will127534/CM4-Nvme-NAS/README.md

# Raspberry Pi Compute Module 4 NVMe array NAS
A simple board for Raspberry Pi Compute Module 4 plus 4x NVMe SSD using ASM1184e

Here is the main description: [https://will127534.github.io/CM4-Nvme-NAS/](https://will127534.github.io/CM4-Nvme-NAS/)

  

  

  

## Notes
* Designed with KiCad 6.0
