will127534/CM4-Nvme-NAS/RaspberryPiNVMeNAS.pdf

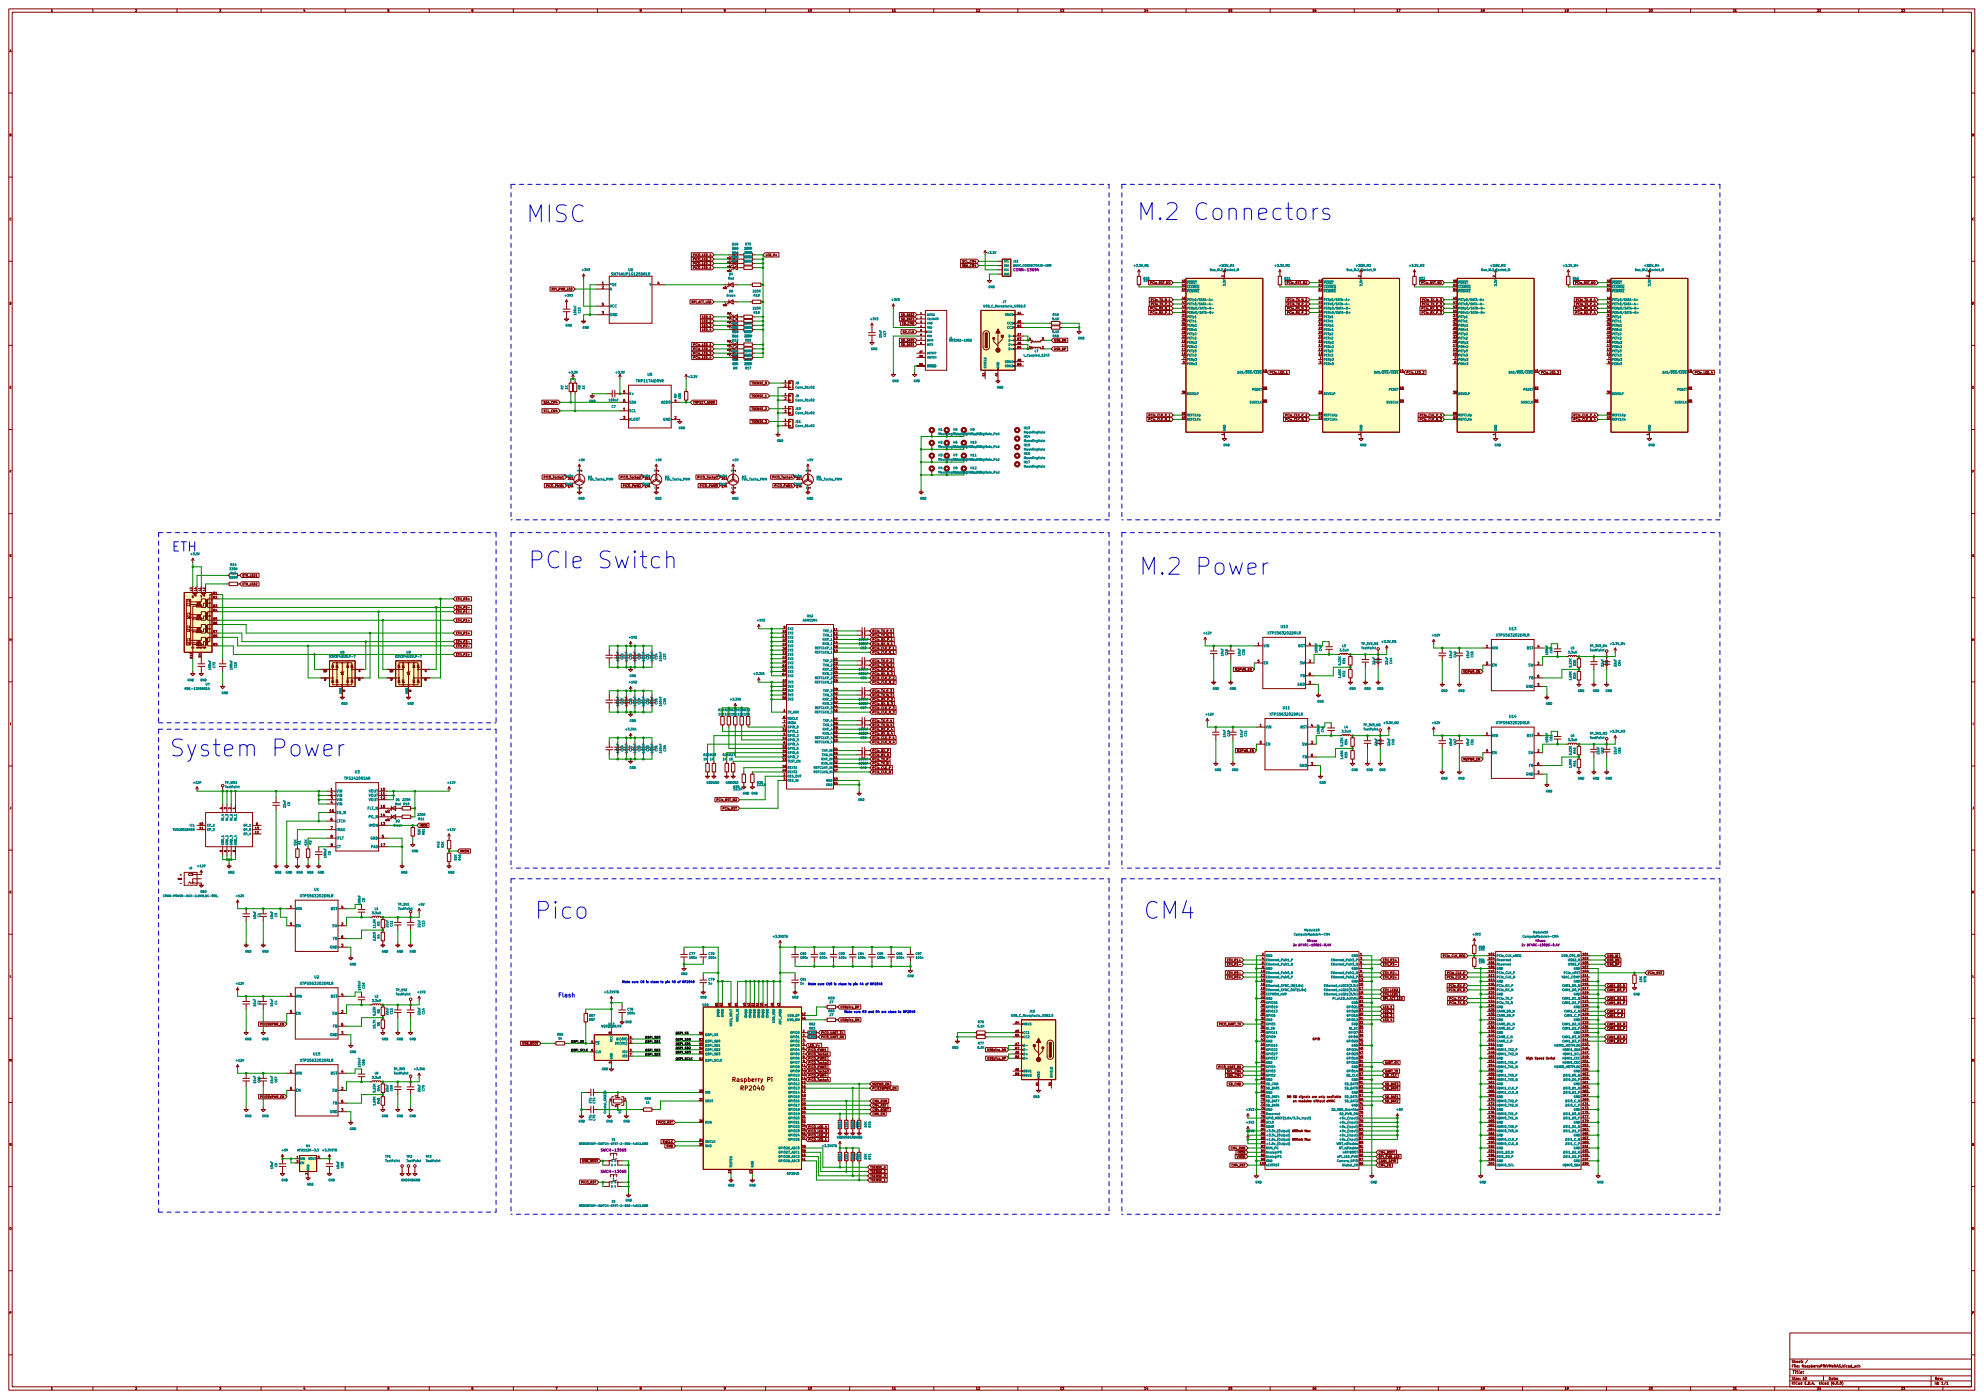
[picture p1: page 1]

H15 MountingHole H14 MountingHole H16 MountingHole H13 MountingHole H2MountingHole_Pad H4MountingHole_Pad H3MountingHole_Pad
H1MountingHole_Pad

GND GND

600mA Max 600mA Max NB SD signals are only available

4 S1 MOMENTARY-SWITCH-SPST-2-SMD-4.6X2.8MM SWCH-13065

4 S2 MOMENTARY-SWITCH-SPST-2-SMD-4.6X2.8MM SWCH-13065
