will127534/CM4-Nvme-NAS/RaspberryPiNVMeNAS.kicad_sch

## KiCad design RaspberryPiNVMeNAS.kicad_sch (2022-01-05)

Schematic: RaspberryPiNVMeNAS.kicad_sch

Parts:
C1, C2, C3, C4, C8, C17, C18, C19, C20, C21, C46, C47, C50, C51, C66, C67, C88: 10uF; C_0805_2012Metric
C5: 22uF; C_0402_1005Metric
C6, C7, C9, C10, C15, C16, C22, C23, C24, C25, C26, C27, C28, C29, C30, C31, C32, C33, C34, C35, C36, C37, C38, C39, C40, C41, C48, C49, C52, C53, C54, C55, C56, C57, C58, C59, C60, C61, C68: 100nF; C_0402_1005Metric
C11, C12, C13, C14, C42, C43, C44, C45, C62, C63, C64, C65, C69, C70: 22uF; C_0805_2012Metric
C73: 100nF; C_1206_3216Metric
C74, C75: 27p; C_0402_1005Metric
C76, C77, C78, C80, C82, C83, C84, C85, C86, C87: 100n; C_0402_1005Metric
C79, C81: 1u; C_0402_1005Metric
D1, D3, D4, D5, D7, D8, D9, D10, D11, D12, D13, D14, D15, D16: Red; LED_0603_1608Metric
D2, D6: Green; LED_0603_1608Metric
H1, H2, H3, H4, H5, H6, H7, H8, H9, H10, H11, H12: MountingHole_Pad; MountingHole_2.7mm_M2.5_Pad_TopOnly
H13, H14, H15, H16, H17: MountingHole; MountingHole_2.7mm_M2.5
IC1: TVS1801DRBR; TPS73601DRBR; Mouser Part Number 595-TVS1801DRBR
J1: 503182-1852; MOLEX_503182-1852
J2, J3, J4, J5: Bus_M.2_Socket_M; 1-2199230-6
J6: CONN-POWER-JACK-2.1MM_DC-005_; DCJ3P-11.6X9.6X7.0MM; MPN DC-005
J7, J15: USB_C_Receptacle_USB2.0; USB_C_Receptacle_XKB_U262-16XN-4BVC11
J8, J9, J10, J11: Conn_01x02; PinHeader_1x02_P2.00mm_Vertical
J12: QWIIC_CONNECTORJS-1MM; 1X04_1MM_RA
L1, L2, L3, L4, L5, L6, L8: 3.3uH; L_Vishay_IHLP-1212
L7: L_Coupled_1243; L_CommonModeChoke_Coilcraft_0805USB
M1, M2, M3, M4: Fan_Tacho_PWM; FanPinHeader_1x04_P2.54mm_Vertical
Module1: ComputeModule4-CM4; Raspberry-Pi-4-Compute-Module
R1, R2, R43, R46, R61: 52K; R_0402_1005Metric
R3: 11.5K; R_0402_1005Metric
R4: 2.21K; R_0402_1005Metric
R5, R31, R34, R38, R40, R44: 5.23K; R_0402_1005Metric
R6: 10.7K; R_0402_1005Metric
R7, R8, R22, R23, R25, R27: 1K; R_0402_1005Metric
R9, R20, R21, R24, R26, R28, R29, R33, R37, R42, R50, R51, R64, R65, R66, R67, R68, R69, R70, R71, R78: 10K; R_0402_1005Metric
R10, R11, R12, R13, R16, R17, R18, R19, R52, R53, R54, R55, R62, R63, R72, R73, R74, R75: 220R; R_0402_1005Metric
R14, R15: 330R; R_0402_1005Metric
R30, R36: 12.1K; R_0402_1005Metric
R32, R35, R39, R41, R45: 1.69K; R_0402_1005Metric
R48, R49, R76, R77: 5.1K; R_0402_1005Metric
R56, R58: 1k; C_0402_1005Metric
R57: DNF; C_0402_1005Metric
R59, R60: 27; C_0402_1005Metric
S1, S2: MOMENTARY-SWITCH-SPST-2-SMD-4.6X2.8MM; TACTILE_SWITCH_SMD_4.6X2.8MM
TP1, TP2, TP3: TestPoint; TestPoint_Pad_D1.0mm
TP_1V2, TP_3V3, TP_3V3_M1, TP_3V3_M2, TP_3V3_M3, TP_3V3_M4, TP_5V1: TestPoint; TestPoint_Pad_D1.0mm
TP_VIN1: TestPoint; TestPoint_Pad_D1.0mm
U1, U2, U10, U11, U13, U14, U15: XTPS563202DRLR
U3: TPS2420RSAR
U4: AP2112K-3.3; SOT-23-5
U5: TMP117AIDRVR
U6: SN74AUP1G125DRLR
U7: RB1-125B8G1A; RJ45_UDE_RB1-125B8G1A
U8, U9: D3V3F4U10LP-7; Diodes_UDFN-10_1.0x2.5mm_P0.5mm
U12: ASM1184; QFN-64-1EP_9x9mm_P0.5mm_EP5.2x5.2mm
U17: W25Q128JVS; DFN-8-1EP_3x2mm_P0.5mm_EP1.36x1.46mm
U18: RP2040; RP2040-QFN-56
Y1: Crystal_GND24; Crystal_SMD_3225-4Pin_3.2x2.5mm

Connections:
+1V2: C12.1, C14.1, C22.1, C23.1, C25.1, C26.1, C28.1, C29.1, C31.1, C32.1, C34.1, C35.1, C37.1, C38.1, L2.2, R5.1, TP_1V2.1, U12.9 (1V2), U12.15 (1V2), U12.17 (1V2), U12.20 (1V2), U12.26 (1V2), U12.29 (1V2), U12.37 (1V2), U12.43 (1V2), U12.48 (1V2), U12.50 (1V2), U12.61 (1V2), U12.64 (1V2)
+1V8: Module1.88 (+1.8v_(Output)), Module1.90 (+1.8v_(Output))
+3.3V: C7.1, J12.2 (VCC), R7.2, R8.2, R9.2, U5.5 (V+), U7.L1, U7.L3
+3.3VA: C24.1, C27.1, C30.1, C33.1, C36.1, C39.1, C69.1, C70.1, L8.2, R24.1, R26.1, R28.1, R29.1, R33.1, R44.1, TP_3V3.1, U12.1 (3V_AUX), U12.10 (3V3), U12.21 (3V3), U12.32 (3V3), U12.38 (3V3), U12.56 (3V3)
+3.3VSTB: C76.1, C80.1, C81.1, C82.1, C83.1, C84.1, C85.1, C86.1, C87.1, C88.1, R57.1, R65.1, R67.1, R69.1, R71.1, U4.5 (VOUT), U17.8 (VCC), U18.1 (IOVDD), U18.10 (IOVDD), U18.22 (IOVDD), U18.33 (IOVDD), U18.42 (IOVDD), U18.43 (ADC_AVDD), U18.44 (VREG_IN), U18.48 (USB_VDD), U18.49 (IOVDD)
+3.3V_M1: C42.1, C44.1, J2.2 (3.3V), J2.4 (3.3V), J2.12 (3.3V), J2.14 (3.3V), J2.16 (3.3V), J2.18 (3.3V), J2.70 (3.3V), J2.72 (3.3V), J2.74 (3.3V), L3.2, R20.1, R31.1, TP_3V3_M1.1
+3.3V_M2: C43.1, C45.1, J3.2 (3.3V), J3.4 (3.3V), J3.12 (3.3V), J3.14 (3.3V), J3.16 (3.3V), J3.18 (3.3V), J3.70 (3.3V), J3.72 (3.3V), J3.74 (3.3V), L4.2, R21.1, R34.1, TP_3V3_M2.1
+3.3V_M3: C63.1, C65.1, J4.2 (3.3V), J4.4 (3.3V), J4.12 (3.3V), J4.14 (3.3V), J4.16 (3.3V), J4.18 (3.3V), J4.70 (3.3V), J4.72 (3.3V), J4.74 (3.3V), L6.2, R37.1, R40.1, TP_3V3_M3.1
+3.3V_M4: C62.1, C64.1, J5.2 (3.3V), J5.4 (3.3V), J5.12 (3.3V), J5.14 (3.3V), J5.16 (3.3V), J5.18 (3.3V), J5.70 (3.3V), J5.72 (3.3V), J5.74 (3.3V), L5.2, R38.1, R42.1, TP_3V3_M4.1
+3V3: C15.1, C17.1, J1.4 (VDD), Module1.78 (GPIO_VREF(1.8v/3.3v_Input)), Module1.84 (+3.3v_(Output)), Module1.86 (+3.3v_(Output)), R50.1, U6.5 (VCC)
+5V: C8.1, C11.1, C13.1, L1.2, M1.2 (+), M2.2 (+), M3.2 (+), M4.2 (+), Module1.77 (+5v_(Input)), Module1.79 (+5v_(Input)), Module1.81 (+5v_(Input)), Module1.83 (+5v_(Input)), Module1.85 (+5v_(Input)), Module1.87 (+5v_(Input)), R3.1, TP_5V1.1, U4.1 (VIN), U4.3 (EN)
+12P: C5.1, IC1.1 (IN_1), IC1.2 (IN_2), IC1.3 (IN_3), IC1.4 (IN_4), J6.1 (+), TP_VIN1.1, U3.1 (VIN), U3.2 (VIN), U3.3 (VIN), U3.4 (VIN)
+12V: C1.1, C2.1, C3.1, C4.1, C18.1, C19.1, C20.1, C21.1, C46.1, C47.1, C50.1, C51.1, C66.1, C67.1, R10.1, R11.1, R43.2, U1.1 (VIN), U1.5 (EN), U2.1 (VIN), U3.10 (VOUT), U3.11 (VOUT), U3.12 (VOUT), U10.1 (VIN), U11.1 (VIN), U13.1 (VIN), U14.1 (VIN), U15.1 (VIN)
CAM1_C_N: Module1.127 (CAM1_C_N)
CAM1_C_P: Module1.129 (CAM1_C_P)
CAM1_D0_N: Module1.115 (CAM1_D0_N)
CAM1_D0_P: Module1.117 (CAM1_D0_P)
CAM1_D1_N: Module1.121 (CAM1_D1_N)
CAM1_D1_P: Module1.123 (CAM1_D1_P)
CAM1_D2_N: Module1.133 (CAM1_D2_N)
CAM1_D2_P: Module1.135 (CAM1_D2_P)
CAM1_D3_N: Module1.139 (CAM1_D3_N)
CAM1_D3_P: Module1.141 (CAM1_D3_P)
CAM1_GPIO: Module1.97 (Camera_GPIO)
CM4_BOOT: Module1.93 (nRPIBOOT), U18.29 (GPIO18)
CM4_EN: Module1.99 (Global_EN), R64.1, U18.30 (GPIO19)
CM4_RST: Module1.100 (nEXTRST), U18.28 (GPIO17)
CM4_RUN: Module1.92 (RUN_PG), R66.1, U18.27 (GPIO16)
ETH_LED1: Module1.19 (Ethernet_nLED1(3.3v)), R14.2
ETH_LED2: Module1.17 (Ethernet_nLED2(3.3v)), R15.2
ETH_P0+: Module1.12 (Ethernet_Pair0_P), U7.R2 (TD1+), U9.5, U9.6 (NC)
ETH_P0-: Module1.10 (Ethernet_Pair0_N), U7.R3 (TD1-), U9.4, U9.7 (NC)
ETH_P1+: Module1.4 (Ethernet_Pair1_P), U7.R5 (TD2-), U9.1, U9.10 (NC)
ETH_P1-: Module1.6 (Ethernet_Pair1_N), U7.R4 (TD2+), U9.2, U9.9 (NC)
ETH_P2+: Module1.11 (Ethernet_Pair2_P), U7.R9 (TD4-), U8.1, U8.10 (NC)
ETH_P2-: Module1.9 (Ethernet_Pair2_N), U7.R8 (TD4+), U8.2, U8.9 (NC)
ETH_P3+: Module1.3 (Ethernet_Pair3_P), U7.R6 (TD3+), U8.5, U8.6 (NC)
ETH_P3-: Module1.5 (Ethernet_Pair3_N), U7.R7 (TD3-), U8.4, U8.7 (NC)
GND: C1.2, C2.2, C3.2, C4.2, C5.2, C6.2, C7.2, C8.2, C11.2, C12.2, C13.2, C14.2, C15.2, C16.2, C17.2, C18.2, C19.2, C20.2, C21.2, C22.2, C23.2, C24.2, C25.2, C26.2, C27.2, C28.2, C29.2, C30.2, C31.2, C32.2, C33.2, C34.2, C35.2, C36.2, C37.2, C38.2, C39.2, C42.2, C43.2, C44.2, C45.2, C46.2, C47.2, C50.2, C51.2, C62.2, C63.2, C64.2, C65.2, C66.2, C67.2, C69.2, C70.2, C73.2, C74.2, C75.2, C76.2, C77.2, C78.2, C79.2, C80.2, C81.2, C82.2, C83.2, C84.2, C85.2, C86.2, C87.2, C88.2, H1.1, H2.1, H3.1, H4.1, H5.1, H6.1, H7.1, H8.1, H9.1, H10.1, H11.1, H12.1, IC1.5 (GND_1), IC1.6 (GND_2), IC1.7 (GND_3), IC1.8 (GND_4), J1.6 (VSS), J1.P1 (SHIELD), J1.P2 (SHIELD), J1.P3 (SHIELD), J1.P4 (SHIELD), J1.P5 (SHIELD), J2.1 (GND), J2.3 (GND), J2.9 (GND), J2.15 (GND), J2.21 (GND), J2.27 (GND), J2.33 (GND), J2.39 (GND), J2.45 (GND), J2.51 (GND), J2.57 (GND), J2.71 (GND), J2.73 (GND), J2.75 (GND), J3.1 (GND), J3.3 (GND), J3.9 (GND), J3.15 (GND), J3.21 (GND), J3.27 (GND), J3.33 (GND), J3.39 (GND), J3.45 (GND), J3.51 (GND), J3.57 (GND), J3.71 (GND), J3.73 (GND), J3.75 (GND), J4.1 (GND), J4.3 (GND), J4.9 (GND), J4.15 (GND), J4.21 (GND), J4.27 (GND), J4.33 (GND), J4.39 (GND), J4.45 (GND), J4.51 (GND), J4.57 (GND), J4.71 (GND), J4.73 (GND), J4.75 (GND), J5.1 (GND), J5.3 (GND), J5.9 (GND), J5.15 (GND), J5.21 (GND), J5.27 (GND), J5.33 (GND), J5.39 (GND), J5.45 (GND), J5.51 (GND), J5.57 (GND), J5.71 (GND), J5.73 (GND), J5.75 (GND), J6.2 (-), J7.A1 (GND), J7.A12 (GND), J7.B1 (GND), J7.B12 (GND), J8.2, J9.2, J10.2, J11.2, J12.1 (GND), J15.A1 (GND), J15.A12 (GND), J15.B1 (GND), J15.B12 (GND), M1.1 (-), M2.1 (-), M3.1 (-), M4.1 (-), Module1.1 (GND), Module1.2 (GND), Module1.7 (GND), Module1.8 (GND), Module1.13 (GND), Module1.14 (GND), Module1.22 (GND), Module1.23 (GND), Module1.32 (GND), Module1.33 (GND), Module1.42 (GND), Module1.43 (GND), Module1.52 (GND), Module1.53 (GND), Module1.59 (GND), Module1.60 (GND), Module1.65 (GND), Module1.66 (GND), Module1.71 (GND), Module1.74 (GND), Module1.98 (GND), Module1.107 (GND), Module1.108 (GND), Module1.113 (GND), Module1.114 (GND), Module1.119 (GND), Module1.120 (GND), Module1.125 (GND), Module1.126 (GND), Module1.131 (GND), Module1.132 (GND), Module1.137 (GND), Module1.138 (GND), Module1.144 (GND), Module1.150 (GND), Module1.155 (GND), Module1.156 (GND), Module1.161 (GND), Module1.162 (GND), Module1.167 (GND), Module1.168 (GND), Module1.173 (GND), Module1.174 (GND), Module1.179 (GND), Module1.180 (GND), Module1.185 (GND), Module1.186 (GND), Module1.191 (GND), Module1.192 (GND), Module1.197 (GND), Module1.198 (GND), R1.2, R2.2, R4.2, R6.2, R22.2, R23.2, R25.2, R27.2, R30.2, R32.2, R35.2, R36.2, R39.2, R41.2, R45.2, R46.2, R48.2, R49.1, R51.2, R61.2, R64.2, R66.2, R68.2, R70.2, R76.2, R77.2, R78.2, S1.3, S1.4, S2.3, S2.4, TP1.1, TP2.1, TP3.1, U1.3 (GND), U2.3 (GND), U3.5 (GND), U3.6 (LTCH), U3.16 (EN_N), U3.17 (PAD), U4.2 (GND), U5.2 (GND), U6.1 (*OE), U6.3 (GND), U7.R10 (GND), U8.3 (VSS), U8.8 (VSS), U9.3 (VSS), U9.8 (VSS), U10.3 (GND), U11.3 (GND), U12.53 (GND), U12.65 (GND), U13.3 (GND), U14.3 (GND), U15.3 (GND), U17.4 (GND), U18.19 (TESTEN), U18.57 (GND), Y1.2, Y1.4
IMON: Module1.94 (AnalogIP0), R61.1, U3.13 (IMON)
LED_1: D9.1 (K), Module1.25 (GPIO21)
LED_2: D10.1 (K), Module1.27 (GPIO20)
LED_3: D11.1 (K), Module1.29 (GPIO16)
LED_4: D12.1 (K), Module1.31 (GPIO12)
LED_V+: R12.2, R13.2, R16.2, R17.2, R18.1, R19.1, R52.2, R53.2, R54.2, R55.2, R72.2, R73.2, R74.2, R75.2, U18.5 (GPIO3)
M2PWR_EN: R70.1, U10.5 (EN), U11.5 (EN), U13.5 (EN), U14.5 (EN), U18.15 (GPIO12)
unnamed: C6.1, U3.9 (CT)
unnamed: C9.1, U1.4 (BST)
unnamed: C9.2, L1.1, U1.2 (SW)
unnamed: C10.1, U2.4 (BST)
unnamed: C10.2, L2.1, U2.2 (SW)
unnamed: C16.1, U7.R1 (CT)
unnamed: C40.1, U10.4 (BST)
unnamed: C40.2, L3.1, U10.2 (SW)
unnamed: C41.1, U11.4 (BST)
unnamed: C41.2, L4.1, U11.2 (SW)
unnamed: C48.2, U12.54 (TXP_IN)
unnamed: C49.2, U12.55 (TXN_IN)
unnamed: C52.2, U12.11 (TXP_1)
unnamed: C53.2, U12.12 (TXN_1)
unnamed: C54.2, U12.22 (TXP_2)
unnamed: C55.2, U12.23 (TXN_2)
unnamed: C56.2, U12.39 (TXP_3)
unnamed: C57.2, U12.40 (TXN_3)
unnamed: C58.2, U12.57 (TXP_4)
unnamed: C59.2, U12.58 (TXN_4)
unnamed: C60.1, U13.4 (BST)
unnamed: C60.2, L5.1, U13.2 (SW)
unnamed: C61.1, U14.4 (BST)
unnamed: C61.2, L6.1, U14.2 (SW)
unnamed: C68.1, U15.4 (BST)
unnamed: C68.2, L8.1, U15.2 (SW)
unnamed: C73.1, U7.SH
unnamed: C74.1, U18.20 (XIN), Y1.1
unnamed: C75.1, R58.2, Y1.3
unnamed: C77.1, C78.1, C79.1, U18.23 (DVDD), U18.45 (VREG_VOUT), U18.50 (DVDD)
unnamed: D1.1 (K), U3.15 (FLT_N)
unnamed: D1.2 (A), R10.2
unnamed: D2.1 (K), U3.14 (PG_N)
unnamed: D2.2 (A), R11.2
unnamed: D3.2 (A), R12.1
unnamed: D4.1 (K), U6.4 (Y)
unnamed: D4.2 (A), R19.2
unnamed: D5.2 (A), R13.1
unnamed: D6.2 (A), R18.2
unnamed: D7.2 (A), R16.1
unnamed: D8.2 (A), R17.1
unnamed: D9.2 (A), R52.1
unnamed: D10.2 (A), R53.1
unnamed: D11.2 (A), R54.1
unnamed: D12.2 (A), R55.1
unnamed: D13.2 (A), R72.1
unnamed: D14.2 (A), R73.1
unnamed: D15.2 (A), R74.1
unnamed: D16.2 (A), R75.1
unnamed: J2.52 (~CLKREQ), R20.2
unnamed: J3.52 (~CLKREQ), R21.2
unnamed: J4.52 (~CLKREQ), R37.2
unnamed: J5.52 (~CLKREQ), R42.2
unnamed: J7.A4 (VBUS), J7.A9 (VBUS), J7.B4 (VBUS), J7.B9 (VBUS)
unnamed: J7.A5 (CC1), R48.1
unnamed: J7.A6 (D+), J7.B6 (D+), L7.1
unnamed: J7.A7 (D-), J7.B7 (D-), L7.4
unnamed: J7.B5 (CC2), R49.2
unnamed: J15.A4 (VBUS), J15.A9 (VBUS), J15.B4 (VBUS), J15.B9 (VBUS)
unnamed: J15.A5 (CC1), R76.1
unnamed: J15.B5 (CC2), R77.1
unnamed: R1.1, U3.7 (IMAX)
unnamed: R2.1, U3.8 (IFLT)
unnamed: R3.2, R4.1, U1.6 (FB)
unnamed: R5.2, R6.1, U2.6 (FB)
unnamed: R14.1, U7.L4
unnamed: R15.1, U7.L2
unnamed: R22.1, U12.8 (GPIO_4)
unnamed: R23.1, U12.5 (GPIO_2)
unnamed: R24.2, U12.31 (GPIO_1)
unnamed: R25.1, U12.35 (GPIO_6)
unnamed: R26.2, U12.30 (GPIO_5)
unnamed: R27.1, U12.33 (TEST_EN)
unnamed: R28.2, U12.36 (GPIO_7)
unnamed: R29.2, U12.34 (GPIO_3)
unnamed: R30.1, U12.16 (REXT1)
unnamed: R31.2, R32.1, U10.6 (FB)
unnamed: R33.2, U12.4 (GPIO_0)
unnamed: R34.2, R35.1, U11.6 (FB)
unnamed: R36.1, U12.49 (REXT2)
unnamed: R38.2, R39.1, U13.6 (FB)
unnamed: R40.2, R41.1, U14.6 (FB)
unnamed: R44.2, R45.1, U15.6 (FB)
unnamed: R58.1, U18.21 (XOUT)
unnamed: R59.2, U18.47 (USB_DP)
unnamed: R60.2, U18.46 (USB_DM)
unnamed: R62.2, U18.2 (GPIO0)
unnamed: R63.2, U18.3 (GPIO1)
PCIESWPWR_EN: R68.1, U2.5 (EN), U15.5 (EN), U18.16 (GPIO13)
PCIe_CLK_N: Module1.112 (PCIe_CLK_N), U12.47 (REFCLKN_IN)
PCIe_CLK_N_1: J2.53 (REFCLKn), U12.19 (REFCLKN_1)
PCIe_CLK_N_2: J3.53 (REFCLKn), U12.28 (REFCLKN_2)
PCIe_CLK_N_3: J4.53 (REFCLKn), U12.45 (REFCLKN_3)
PCIe_CLK_N_4: J5.53 (REFCLKn), U12.63 (REFCLKN_4)
PCIe_CLK_P: Module1.110 (PCIe_CLK_P), U12.46 (REFCLKP_IN)
PCIe_CLK_P_1: J2.55 (REFCLKp), U12.18 (REFCLKP_1)
PCIe_CLK_P_2: J3.55 (REFCLKp), U12.27 (REFCLKP_2)
PCIe_CLK_P_3: J4.55 (REFCLKp), U12.44 (REFCLKP_3)
PCIe_CLK_P_4: J5.55 (REFCLKp), U12.62 (REFCLKP_4)
PCIe_CLK_REQ: Module1.102 (PCIe_CLK_nREQ), R50.2, R51.1
PCIe_LED_1: D3.1 (K), J2.10 (DAS/~DSS/~LED1)
PCIe_LED_2: D5.1 (K), J3.10 (DAS/~DSS/~LED1)
PCIe_LED_3: D7.1 (K), J4.10 (DAS/~DSS/~LED1)
PCIe_LED_4: D8.1 (K), J5.10 (DAS/~DSS/~LED1)
PCIe_RST: Module1.109 (PCIe_nRST), R78.1, U12.3 (RES_IN)
PCIe_RST_M2: J2.50 (~PERST), J3.50 (~PERST), J4.50 (~PERST), J5.50 (~PERST), U12.2 (RES_OUT)
PCIe_RX_N: C49.1, Module1.118 (PCIe_RX_N)
PCIe_RX_N_1: J2.43 (PERp0/SATA-B-), U12.14 (RXN_1)
PCIe_RX_N_2: J3.43 (PERp0/SATA-B-), U12.25 (RXN_2)
PCIe_RX_N_3: J4.43 (PERp0/SATA-B-), U12.42 (RXN_3)
PCIe_RX_N_4: J5.43 (PERp0/SATA-B-), U12.60 (RXN_4)
PCIe_RX_P: C48.1, Module1.116 (PCIe_RX_P)
PCIe_RX_P_1: J2.41 (PERn0/SATA-B+), U12.13 (RXP_1)
PCIe_RX_P_2: J3.41 (PERn0/SATA-B+), U12.24 (RXP_2)
PCIe_RX_P_3: J4.41 (PERn0/SATA-B+), U12.41 (RXP_3)
PCIe_RX_P_4: J5.41 (PERn0/SATA-B+), U12.59 (RXP_4)
PCIe_TX_N: Module1.124 (PCIe_TX_N), U12.52 (RXN_IN)
PCIe_TX_N_1: C53.1, J2.49 (PETp0/SATA-A+)
PCIe_TX_N_2: C55.1, J3.49 (PETp0/SATA-A+)
PCIe_TX_N_3: C57.1, J4.49 (PETp0/SATA-A+)
PCIe_TX_N_4: C59.1, J5.49 (PETp0/SATA-A+)
PCIe_TX_P: Module1.122 (PCIe_TX_P), U12.51 (RXP_IN)
PCIe_TX_P_1: C52.1, J2.47 (PETn0/SATA-A-)
PCIe_TX_P_2: C54.1, J3.47 (PETn0/SATA-A-)
PCIe_TX_P_3: C56.1, J4.47 (PETn0/SATA-A-)
PCIe_TX_P_4: C58.1, J5.47 (PETn0/SATA-A-)
PICO_LED_1: D13.1 (K), U18.37 (GPIO25)
PICO_LED_2: D14.1 (K), U18.36 (GPIO24)
PICO_LED_3: D15.1 (K), U18.35 (GPIO23)
PICO_LED_4: D16.1 (K), U18.34 (GPIO22)
PICO_PWM1: M1.4 (PWM), U18.6 (GPIO4)
PICO_PWM2: M2.4 (PWM), U18.8 (GPIO6)
PICO_PWM3: M3.4 (PWM), U18.11 (GPIO8)
PICO_PWM4: M4.4 (PWM), U18.13 (GPIO10)
PICO_RST: S2.1, S2.2, U18.26 (RUN)
PICO_Tacho1: M1.3 (Tacho), U18.7 (GPIO5)
PICO_Tacho2: M2.3 (Tacho), U18.9 (GPIO7)
PICO_Tacho3: M3.3 (Tacho), U18.12 (GPIO9)
PICO_Tacho4: M4.3 (Tacho), U18.14 (GPIO11)
PICO_UART_RX: Module1.54 (GPIO4), R63.1
PICO_UART_TX: Module1.34 (GPIO5), R62.1
QSPI_SCLK: U17.6 (CLK), U18.52 (QSPI_SCLK)
QSPI_SD0: U17.5 (DI(IO0)), U18.53 (QSPI_SD0)
QSPI_SD1: U17.2 (DO(IO1)), U18.55 (QSPI_SD1)
QSPI_SD2: U17.3 (IO2), U18.54 (QSPI_SD2)
QSPI_SD3: U17.7 (IO3), U18.51 (QSPI_SD3)
QSPI_SS: R56.1, R57.2, U17.1 (~CS), U18.56 (QSPI_SS)
RPI_ACT_LED: D6.1 (K), Module1.21 (PI_nLED_Activity)
RPI_PWR_LED: Module1.95 (nPI_LED_PWR), U6.2 (A)
SCL_CM4: J12.4 (SCL), Module1.56 (GPIO3), R8.1, U5.1 (SCL)
SDA_CM4: J12.3 (SDA), Module1.58 (GPIO2), R7.1, U5.6 (SDA)
SD_CLK: J1.5 (CLK), Module1.57 (SD_CLK)
SD_CMD: J1.3 (CMD), Module1.62 (SD_CMD)
SD_DAT0: J1.7 (DAT0), Module1.63 (SD_DAT0)
SD_DAT1: J1.8 (DAT1), Module1.67 (SD_DAT1)
SD_DAT2: J1.1 (DATA2), Module1.69 (SD_DAT2)
SD_DAT3: J1.2 (CD/DAT3), Module1.61 (SD_DAT3)
SWCLK: U18.24 (SWCLK)
SWD: U18.25 (SWD)
TMP117_ADDR: R9.1, U5.4 (ADD0)
TSENSE_0: J8.1, R65.2, U18.38 (GPIO26_ADC0)
TSENSE_1: J9.1, R71.2, U18.41 (GPIO29_ADC3)
TSENSE_2: J10.1, R67.2, U18.39 (GPIO27_ADC1)
TSENSE_3: J11.1, R69.2, U18.40 (GPIO28_ADC2)
UART_RX: Module1.51 (GPIO15)
UART_TX: Module1.55 (GPIO14)
USB_DN: L7.3, Module1.103 (USB2_N)
USB_DP: L7.2, Module1.105 (USB2_P)
USB_ID: Module1.101 (USB_OTG_ID)
USBpico_DN: J15.A7 (D-), J15.B7 (D-), R60.1
USBpico_DP: J15.A6 (D+), J15.B6 (D+), R59.1
VMON: Module1.96 (AnalogIP1), R43.1, R46.1
~USB_BOOT: R56.2, S1.1, S1.2

Notes on the sheet:
M.2 Power
Make sure R3 and R4 are close to RP2040
MISC
System Power
Make sure C8 is close to pin 45 of RP2040
M.2 Connectors
PCIe Switch
Make sure C10 is close to pin 44 of RP2040
Pico
Flash
CM4
ETH
