will127534/CM4-Nvme-NAS/(threads)

Thread 1 (2022-01-27):

BOM

SozinovD, 2022-01-27:
Hi, its a great project, i even think to build it myself, can you add Bill Of Material please?

will127534, 2022-02-01:
I think you can generate the BOM with the pcb files.

Thread 2 (2023-01-12):

USB C power

mr4lexndr, 2023-01-12:
Hi, as I understand a 12V dc jack powers the board. are you planning to use USB C as a power source? It would be a great feature for me.

will127534, 2023-01-13:
Nope, USB-C is for the on-board Pico.
The entire board loaded with NVMe needs USB-PD for higher power, so even if I added USB-C power source I think there will be issues where people plugged it in a 5V only charger.

You can use a USB-C to DC Jack cable with 12V PD, this is actually my current configuration.

Closed 2023-01-13.

Thread 5 (2024-08-08):

+/- of PCIe RX and TX differential pairs flipped?

dumtux, 2024-08-08:
Looking at your schematics, I found interesting flipped differential pair connection. `TX` and `RX` are flipped to M.2 M connector. But `CLK` is not flipped. Could you explain why?
(It's same for all four M.2 connectors.)

### Flipped `TX` and `RX`

| ASM1184        |  M.2 M conn 1   |
| -------------- | ---------------- |
| `PCIe_TX_N_1`  |  (49) `PETp0`    |
| `PCIe_TX_P_1`  |  (47) `PETn0`    |
| `PCIe_RX_N_1`  |  (43) `PERp0`    |
| `PCIe_RX_P_1`  |  (41) `PERn0`    |

### Not-flipped `CLK`

| ASM1184        |  M.2 M conn 1   |
| -------------- | ---------------- |
| `PCIe_CLK_P_1` |  (55) `REFCLKp`  |
| `PCIe_CLK_N_1` |  (53) `REFCLKn`  |

dumtux, 2024-08-08:
I found that PCIe is diff pair polarity agnostic.
Further reading: https://www.teledynelecroy.com/doc/understanding-lane-reversal-and-polarity

prasimix, 2025-01-27:
Maybe it would be a good idea to correct the p0 / B- and n0 / B+ markings?
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

will127534, 2025-01-29:
> Maybe it would be a good idea to correct the p0 / B- and n0 / B+ markings? 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

No, please follow the M.2 connector spec

Closed 2024-08-08.
